CasualCodersProjects/DS4-Type-C/README.md

# DS4-Type-C
## Heads up!
This project has reached EOL. It is no longer under active development. PRs will be merged, but I no longer intend to update boards. Feel free to use all of the info provided here to make modifications to boards like using new parts or LEDs. These are pretty basic though, so this should hopefully hold until the DS4 controller is well discontinued.

## Background
Hate microUSB? Looking to decrease cable clutter? This is the PS4 mod for you. This repo aims to host mostly drop-in USB Type C replacement boards for all revisions of PS4 controller. Each board follow the USB Type C legacy standard, allowing C to C charging and data transfer at USB 2.0 speeds. The overall project goal is to keep all possible parts the same between boards, and to make it reasonablly easy for a person of moderate skill to populate these boards. This is an open source project though, so you're free to download [KiCad](https://www.kicad.org/download/) and start making modifications to these boards so that you can more easily populate them.

I used a 0.8mm PCB when I originally made these, and found it worked quite well. Gives a little more room to work inside the controller. Cost will likely depend on which board house you choose to go through. 

#### The Casual Coders Tindie store is now live! Head on over to [shop.casualcoders.dev](https://shop.casualcoders.dev) or [tindie.com/stores/casualcoders](https://www.tindie.com/stores/casualcoders/) (they're the same thing) if you'd like to purchase PCBs, Kits, or Pre-Assembled boards by one of us!

## Tutorial To Manufacture and assemble these boards.
Tutorial to manufacture these boards (http://www.youtube.com/watch?v=DVEYy7VKs3Q)

# Supported boards

| DS4 Board | Tested  | PCB | Connector | Pictures | Credits |
|---|---|---|---|---|---|
| **JDS-001** | ✔ | [001](/001) | 14 | [Schematic](/001/001.svg), [Front](/001/001_Front.png), [Back](/001/001_Back.png) | [^cred001] |
| **JDS-011** | ✔ | [011](/011) | 12 | [Schematic](/011/011.svg), [Front](/011/011_Front.png), [Back](/011/011_Back.png) | [^cred011] [^cred001] |
| **JDS-030** | ✔ | [030](/030) | 12 | [Schematic](/030/030.svg), [Front](/030/030_Front.png), [Back](/030/030_Back.png) | [^cred030] |
| **JDS-040** | ✔ | [040-055](/040%20055) | 12 | [Schematic](/040%20055/040%20055.svg), [Front](/040%20055/040%20055_Front.png), [Back](/040%20055/040%20055_Back.png) | [^cred055] |
| **JDS-05X** | ✔ | [040-055](/040%20055) | 12 | [Schematic](/040%20055/040%20055.svg), [Front](/040%20055/040%20055_Front.png), [Back](/040%20055/040%20055_Back.png) | [^cred055] |

[^cred001]:
    The original shape for this board was done [here](https://github.com/HDR/DualShock4-USB-C) by Martin Refseth. Thxandbye created the schematic and laid the traces on top.
[^cred011]:
    Thanks to IcicaSora for providing the schematic for 011
[^cred030]:
    Thanks to 12brendan3 for providing the schematic for 030
[^cred055]:
    According to reddit user [u/Mcorgano](https://www.reddit.com/r/PS4Mods/comments/p2q3da/selling_dropin_replacement_type_c_charge_boards/h8oozja/) the pinout is supposedly the same between JDS-040 and JDS-055. The [idea](https://www.reddit.com/r/PS4Mods/comments/p2q3da/selling_dropin_replacement_type_c_charge_boards/h8os8rh/) for this dual board also comes from the same user.  
As of 11/08/2021, the 055 pinout has been confirmed by reddit user [u/jrmanpt](https://old.reddit.com/r/PS4Mods/comments/p6g08b/open_sourcing_the_type_c_charge_boards_help_me/hjoxedu/)
    
### Universal
The idea here is to create one "panelized" board which contains all above boards (JDS 001, 011, 030, 040, 050, 055). This means that someone could easily acquire a board for all controllers, then populate the one they need.  
Work can now begin for this panel.

This is not something I plan to do anymore. If you'd like to do this and submit a PR, feel free and I'll merge it.  
 -Ian

# Parts
- RGB LED:          [FM-3510RGBA-SG](https://www.lcsc.com/product-detail/Light-Emitting-Diodes-LED_Foshan-NationStar-Optoelectronics-FM-3510RGBA-SG_C727903.html)
- USB Type C:           [Type-C-31-M-12](https://www.lcsc.com/product-detail/USB-Type-C_Korean-Hroparts-Elec-TYPE-C-31-M-12_C165948.html)
- FPC Connector - 12:   [503480-1200](https://www.lcsc.com/product-detail/FFC-FPC-Connectors_MOLEX-5034801200_C587969.html)
- FPC Connector - 14:   [503480-1400](https://www.mouser.com/ProductDetail/Molex/503480-1400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)
- Resistors:            [0603](https://www.mouser.com/Passive-Components/Resistors/Film-Resistors/Thin-Film-Resistors-SMD/_/N-7gz44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)
    - 2x 5.1k Ohm (Allows C to C charging)
