CasualCodersProjects/DS4-Type-C/Gerbers/README.md

You should be safe to simply download the .zip file from this directory and upload it to your board house. If it doesn't look right, you can download the raw gerbers in the associated folder. Or, if you know how to use KiCad (Digikey has a good tutorial covering it), you can download the raw project and export your own.
