CasualCodersProjects/DS4-Type-C/(threads)

Thread 1 (2022-03-02):

JDS-011 Board pictures

IcicaSora, 2022-03-02:
https://drive.google.com/drive/folders/1vvhLrmgItue2Wch3YJ4nsu_PF8t5DVdx?usp=sharing

While I don't plan to mod my controller, good luck with your project :)

12ian3, 2022-03-02:
Those photos are fantastically useful, and give me the board outline. If you have access to a multimeter, would you be able to get me a pinout on the FPC Connector, LED, and USB? I don't feel like trying to guess and figure out traces from photos.
Biggest things would be 5v, GND, Data +, Data -. That would net a useful board, just without the LED. If you can also trace back the LED pins, that'd be everything I need to spin up a fully functional JDS-011 board.

Here's a photo with MicroUSB's pinout to help with that.
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

Thanks!

chand1012, 2022-03-03:
@IcicaSora thank you for the images! Closing issue.

IcicaSora, 2022-03-04:
Apparently [this](https://github.com/HDR/DualShock4-USB-C) already did the handy work (no schematics tho, only gerber, might still be useful).

IcicaSora, 2022-03-04:
there're 2 pins that are connected to each other but are not connected to gnd or vcc, not sure what they're for

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

12ian3, 2022-03-04:
Yeah. I based 001 off that, however it's not correct for 011. Note that 011 only has 12 pins on the fpc connector. It may have the same pinout, just two pins shorter, but I can't say for sure without measuring anything.

Mar 4, 2022 11:54:44 IcicaSora ***@***.***>:

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

12ian3, 2022-03-04:
> there're 2 pins that are connected to each other but are not connected to gnd or vcc, not sure what they're for
>
> 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

Thank you for your work! I've modified the 001 board to include pads for the 011 board. Hopefully that works. I really like the idea of dual boards, as it reduces overhead and makes it more versatile. I'll get that pushed to the repo soon™.

IcicaSora, 2022-03-05:
Have another question: what are the use of the 0 ohm resistors on R3 and R4, and could I just bridge them without using any resistors?

12ian3, 2022-03-06:
>

I'll assume that's for the 001/011 board. Those are impedance matching resistors for those who think that's truly necessary. I don't see it as necessary, so you should use 0Ω resistors for the most professional/cleanest build. They're like 2 cents each. You could bridge them together if you really need to though.

Closed 2022-03-04.

Thread 2 (2022-03-09):

I have a JDS-030 controller, how can I help?

adamboy7, 2022-03-09:
I have a multimeter, a digital caliper, but I've never used PCB building software before. Do I just need to provide dimensions and continuity between pins? I'm also not sure what to make of the two chips in the upper right bottom side, I think one of them _might_ be a mosfet? I'm not sure, how can I help?
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

12ian3, 2022-03-09:
You're in luck, because I just added 030 to this repo. All the required files to fab boards should be associated with this commit: https://github.com/12ian3/DS4-Type-C/commit/adab8a4524bf502062ee0863a6762c9f91443fbd

Thread 4 (2022-03-30):

Question about 5.1kOhm pull-down resistors for CC1 and CC2

CSab6482, 2022-03-30:
I was planning on removing the micro-USB port from my DS4 board and soldering in a USB-C connector (similar to [this video](https://youtu.be/fk7J3LPLqRE) and [this one](https://youtu.be/-FndDPk_CGY)), but that would require that I offset my LED, and I wanted to retain its original position and functionality.

When I found this project, I figured it was a much better fit. Unfortunately, it's only cost effective to make multiple boards, and I only have one controller with a JDS-030 board. Given that, I am eagerly awaiting the opening of the tindie shop with pre-built configurations.

However, my question relates to the ability to use this port with USB-C to USB-C cables. My understanding is that in order to do this, pins A5 and B5 need to be connected to ground with a 5.1kOhm pull-down resistor. Do these boards have connection points for these resistors? For example, [this image](https://github.com/12ian3/DS4-Type-C/blob/main/040%20055/040%20055_Front.png) of the 040/055 board has six spots for resistors to be soldered onto, but what is the resistance measurement of these resistors, and do any of them connect CC1 and CC2 to ground? I was not able to find any recommended resistance levels on the [parts section](https://github.com/12ian3/DS4-Type-C#parts).

In any case, I found that RG1608P-512-D-T5 and RTT03512JTP resistors are the correct 0603 size and they are rated for 5.1kOhms. Would it be better to update the parts section to specify a certain resistance, or will different boards require different resistances?

CSab6482, 2022-03-30:
I found [this similar project](https://youtu.be/jyw3BSlLAMU?t=64) for the JDS-055 board (timestamped when the creator mentions the USB-C to USB-C functionality), maybe certain parts of both projects could be merged together? This design only uses one side of the PCB.

12ian3, 2022-03-30:
You'll find these resistors on all 3 of my designs. Two of them are indeed 5.1k pull downs to ground on CC1 and CC2 of the USB C port. The other two are 0 ohm resistors which are unnecessary, but can allow for impedance matching. When I started this project, I mistook the common mode choke for a resistor network which I assumed was for impedance matching, hence the zero ohm resistors. The 040/05X board is the exception here, since it contains 4 zero ohm resistors. Only two are designed to be populated though.

CSab6482, 2022-03-30:
Gotcha, is there any way for me to know which pads should have the zero ohm resistors and which ones should have the 5.1k ones? I'm still a bit newbish to reading schematics and gerber files and all that.

12ian3, 2022-03-30:
You're correct for 040/055. It may be different for the other boards. I can possibly make some modifications to ensure that R1 and R2 are always the 5.1k resistors and that 3-4(6) are 0 ohms. I won't commit to that just yet though.

CSab6482, 2022-03-30:
Thank you so much for that explanation, I'll keep an eye out for the other boards and I completely understand if it is not possible to make all the resistor locations line up.

Closed 2022-03-30.

Thread 5 (2022-04-07):

030 does not work

12ian3, 2022-04-07:
Board 030 has the incorrect pinout. Vcc should be pins 5 and 6 of the FPC, and pin 8 of the FPC is the Annode of the RGB LED

12ian3, 2022-04-18:
Should've been fixed last night with the latest push. Will leave this issue open until confirmed.

GrimKriegor, 2022-07-13:
As of 5adb2fcc35c69b2be41fc0fdc34ab9da58bddd39, 030 seems to be working perfectly.
C to C charging has not been tested.
Thank you for your efforts!
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

Closed 2022-08-03.

Thread 6 (2022-04-07):

Board 011 does not have the correct pinout

12ian3, 2022-04-07:
As with 030, the pinout is incorrect. 5 and 6 should be VCC, and 8 should be the Annode of the RGB LED

12ian3, 2022-04-18:
Should've been fixed last night with the latest push. Will leave this issue open until confirmed.

JustinWalravens, 2022-08-03:
Hello,
The problem is fix ?
thanks

JustinWalravens, 2022-08-03:
Besides, I'm having trouble finding the right reference for the 011 LED.
 Do you have references?
 Thanks in advance.

12ian3, 2022-08-03:
> Hello, The problem is fix ? thanks

JDS-011 has been working since commit 680932b3be2552280a675500a78e0a35e2cc8f59.
The LED actively in use can be found at the bottom of the readme page, with a link to LCSC where there are presently 22,000 in stock. Should you wish to go back to the RHOM LEDs, that is under the RHOM-LEDs branch, though I cannot guarntee function, and also has no support.

JustinWalravens, 2022-08-03:
OK, thanks
 What I didn't understand was that the size of the link LEDs, are much smaller than the original LED.
 But so if I understand correctly the footprints on the new pcb are the size of the new LED.

Closed 2022-08-03.

Thread 8 (2022-08-11):

Board Question

KozmikNano, 2022-08-11:
Sorry if this is a dumb question but, which Board is considered the best for playing with USB and charging?

12ian3, 2022-08-11:
Hi there,

I don't understand your question. Would you be able to rephrase it for me?

Thanks!

Aug 11, 2022 15:23:17 KozmikNano ***@***.***>:

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

KozmikNano, 2022-08-11:
Out of the list of boards that works for this project, which one is the best? Are they all the same?

12ian3, 2022-08-11:
Each board is unique to a specific controller. They are all the same general schematic, however certain shapes and pinouts are different. Otherwise, they all work the same.

You'll have to open your controller and figure out which of the 5 different models of boards your controller uses, then fab the correct replacement.

KozmikNano, 2022-08-11:
Ok, thanks!

Closed 2022-08-11.

Thread 9 (2022-09-21):

Gerber still uses old LEDs

crashniels, 2022-09-21:
Got myself a few of the 011 and 030 boards. The LEDs listed are the newer ones but the Gerber hasn't been updated for these it seems. They still use the old 7 pin ones (mine are 4 that I ordered).

12ian3, 2022-09-21:
Confirmed this is an issue. Please export the Gerbers from source for the time being. Fixing this is an incredibly low priority for me at the moment. I'll mark it down, and repair it when I get around to it.

Closed 2024-10-16.

Thread 11 (2023-05-21):

Boards are a bit loose on the shell

vrtlspd, 2023-05-21:
Why not include the screw hole in the boards? I think it has enough space for it. Instead of including your logo on the top, you should put it below the LED. Please consider this, I'm not the only one complaining about this.

CC-Ian, 2023-05-22:
I appreciate the concern and the idea, though I truly do not believe my design has the room to make this work. I believe there is a clearance issue between the hole, and the physically deeper USB Type C receptacle.

As it stands, I have no intention of implementing this change, as once the last few boards sell out on Tindie, I no longer intend to sell these.

At any rate, the project is fully open source, so you're free to fork the project and attempt to add the mounting hole yourself. You could even replace the USB C receptacle with a shallower version, provided you can find a suitable replacement online.

Closed 2023-05-22.

Thread 12 (2024-12-17):

pcb modifications

shoyrock, 2024-12-17:
I don't know if this is something that you all would be able to implement, but you would only need to possibly convert all the versions of the PS4 controllers. hopefully someone is still working on this project and see this post
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

shoyrock, 2024-12-17:
oh also would be nice if there was a BOM.xls and CPL.xls
