CasualCodersProjects/DS4-Type-C/(commit log)

2021-08-12 Added kicad project with schematic for 040 and 055
    [040 055.kicad_pcb, 040 055.sch]
2021-08-12 Updated netlist and started initial PCB layout
    [040 055.sch]
2021-08-12 Added libraries for molex FPC connector and LED footprints
    [040 055.kicad_pcb, 040 055.sch]
2021-08-12 Did some work on PCB 040. Have molex connector, USB, and Resistors in place.
    [040 055.kicad_pcb]
2021-08-14 Finalized PCB which should work for 040 and 055. 055 needs tested. It assumes the same pinout as 044.
    [040 055.kicad_pcb, 040 055.sch]
2021-08-14 Added pcb and schematic for JDS-001
    [001.kicad_pcb, 001.sch]
2021-08-17 updated LED symbol with correct pinout for 040 055
    [040 055.kicad_pcb, 040 055.sch]
2021-08-18 Added gerber files for 040 05X
    [040 055-B_Cu.gbr, 040 055-B_Mask.gbr, 040 055-B_SilkS.gbr, 040 055-Edge_Cuts.gbr, 040 055-F_Cu.gbr, 040 055-F_Mask.gbr, 040 055-F_SilkS.gbr, 040 055-NPTH.drl]
2021-11-09 Confirmed that 055 board works
    updated README to include the above.
2022-02-11 Added images
    [040 055.kicad_pcb, 040 055.sch]
2022-02-12 moved gerber files, added notes.
2022-02-26 Updated schematic, added addtiional info and images to readme
    [001.sch, XXX.kicad_pcb, XXX.sch]
2022-02-26 Added pregenerated gerbers for 001
    [001-B_Cu.gbr, 001-B_Mask.gbr, 001-B_SilkS.gbr, 001-Edge_Cuts.gbr, 001-F_Cu.gbr, 001-F_Mask.gbr, 001-F_SilkS.gbr, 001-NPTH.drl]
2022-03-05 Modified 001 to have pads to be used for 011 as well.
    [001.kicad_pcb, 001.sch]
2022-03-08 Added board 030 thanks to 12brendan3
    [030.kicad_pcb, 030.sch, 030_outline.dxf, XXX.kicad_pcb, XXX.sch]
2022-03-08 added pre-gen 030 gerbers
    [030-B_Cu.gbr, 030-B_Mask.gbr, 030-B_SilkS.gbr, 030-Edge_Cuts.gbr, 030-F_Cu.gbr, 030-F_Mask.gbr, 030-F_SilkS.gbr, 030-NPTH.drl]
2022-03-09 Added credit to 001/011 boards. Thanks to IcicaSora and Martain Refseth for this board!
    [001-B_Cu.gbr, 001-B_Mask.gbr, 001-B_SilkS.gbr, 001-Edge_Cuts.gbr, 001-F_Cu.gbr, 001-F_Mask.gbr, 001-F_SilkS.gbr, 001-NPTH.drl]
2022-03-09 renamed folder to show the correct status as a combined board.
    [001.kicad_pcb, 001.sch]
2022-03-09 Updated readme to include new boards and more information.
2022-03-30 Standardized Resistor names. Added pictures. Updated readme
    [030-B_Cu.gbr, 030-B_Mask.gbr, 030-B_SilkS.gbr, 030-Edge_Cuts.gbr, 030-F_Cu.gbr, 030-F_Mask.gbr, 030-F_SilkS.gbr, 030-NPTH.drl]
2022-04-07 update readme to indicate bad boards for 011 and 030
2022-04-08 added link to the store for premade boards and kits
2022-04-17 update 030 to potentially correct schematic. Remove bad 001/011.
    [001-B_Cu.gbr, 001-B_Mask.gbr, 001-B_SilkS.gbr, 001-Edge_Cuts.gbr, 001-F_Cu.gbr, 001-F_Mask.gbr, 001-F_SilkS.gbr, 001-NPTH.drl]
2022-04-17 Gerbers in wrong spot -- 030
2022-04-17 Updated 011 to have the hopefully correct schematic Still a split board bridge the tiny resistor pad for LED function on 001
    [001-Edge_Cuts.dxf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]
2022-04-18 001, 011, 030 standardized to a cheaper LED
    [001.kicad_pcb, 001.sch, 030.kicad_pcb, 030.sch]
2022-07-22 Second to last Commit
    [001-B_Cu.gbr, 001-B_Mask.gbr, 001-B_SilkS.gbr, 001-Edge_Cuts.gbr, 001-F_Cu.gbr, 001-F_Mask.gbr, 001-F_SilkS.gbr, 001-NPTH.drl]
2022-07-22 Final, EOL Commit
    [001-Edge_Cuts.dxf, 001.kicad_pcb, 001.sch, 011.kicad_pcb]
2022-10-30 Added JDS-001
    [001-Edge_Cuts.dxf, 001.kicad_pcb, 001.kicad_sch, 001.sch]
2022-10-30 Schematic svg plot for 001
2022-10-30 JDS-001 Gerbers
    [001-B_Cu.gbr, 001-B_Mask.gbr, 001-B_Silkscreen.gbr, 001-Edge_Cuts.gbr, 001-F_Cu.gbr, 001-F_Mask.gbr, 001-F_Silkscreen.gbr, 001-job.gbrjob]
2022-10-30 JDS-001 Gerber zip
2022-11-23 040/05x minor update to Vcc pads. Updated Gerbers
    [040 055-B_Cu.gbr, 040 055-B_Mask.gbr, 040 055-B_Silkscreen.gbr, 040 055-Edge_Cuts.gbr, 040 055-F_Cu.gbr, 040 055-F_Mask.gbr, 040 055-F_SilkS.gbr, 040 055-F_Silkscreen.gbr]
2022-11-23 030 minor rework and gerber update
    [030-B_Cu.gbr, 030-B_Mask.gbr, 030-B_Silkscreen.gbr, 030-Edge_Cuts.gbr, 030-F_Cu.gbr, 030-F_Mask.gbr, 030-F_SilkS.gbr, 030-F_Silkscreen.gbr]
2022-11-23 Updated 011 gerbers
    [001-B_Cu.gbr, 001-B_Mask.gbr, 001-B_SilkS.gbr, 001-Edge_Cuts.gbr, 001-F_Cu.gbr, 001-F_Mask.gbr, 001-F_SilkS.gbr, 001-NPTH.drl]
2024-03-21 Update footprint to be correct
2024-03-21 Update to v2.0 in full
    [001-Edge_Cuts.dxf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]
2024-03-22 Add all release gerbers
    [001-v2-B_Cu.gbr, 001-v2-B_Mask.gbr, 001-v2-B_Paste.gbr, 001-v2-B_Silkscreen.gbr, 001-v2-Edge_Cuts.gbr, 001-v2-F_Cu.gbr, 001-v2-F_Mask.gbr, 001-v2-F_Paste.gbr]
2024-03-22 Corrected export mistake. 040/05x
    [030-011-v2-B_Cu.gbr, 030-011-v2-B_Mask.gbr, 030-011-v2-B_Paste.gbr, 030-011-v2-Edge_Cuts.gbr, 030-011-v2-F_Cu.gbr, 030-011-v2-F_Mask.gbr, 030-011-v2-F_Paste.gbr, 030-011-v2-F_Silkscreen.gbr]
